Omnicrola/filking-hats/hat-conductor/hat-conductor.ino

#include "config.h"
#include "settings.h"
#include "display.h"
#include "audio.h"
#include "radio.h"
#include "web.h"
#include "mode.h"
#include "bell.h"
#include <WiFi.h>

void setup() {
#if DEBUG
  Serial.begin(115200);
#endif
  settingsBegin();
  displayBegin();
  startupChase();
  bool micOk = audioBegin();
  bool radioOk = radioBegin();
  webBegin();
  DBG("conductor v%u mic %s, radio %s ch %u, web http://%s\n", FIRMWARE_VERSION, micOk ? "ok" : "FAIL",
      radioOk ? "ok" : "FAIL", radioChannel(), WiFi.softAPIP().toString().c_str());
}

void metronomeLoop() {
  static uint32_t lastFrameMs = 0;
  uint32_t now = millis();
  if (now - lastFrameMs >= METRONOME_FRAME_MS) {
    lastFrameMs = now;
    uint8_t level, hue;
    metronomeFrame(level, hue);
    broadcast(level, hue, MODE_METRONOME);
    renderBar(level, hue);
  }
  webHandle();
}

void loop() {
  if (modeCurrent() == MODE_METRONOME) {
    metronomeLoop();
    return;
  }
  uint8_t mode = modeCurrent();
  AudioFrame f = audioProcess(mode == MODE_FREQUENCY);
  broadcast(f.level, f.hue, mode);
  if (mode == MODE_FREQUENCY) broadcastSpectrum(f.bands);
  if (mode == MODE_BELL) bellFrame(f);
  else if (mode == MODE_SLEEP) renderOff();
  else if (mode == MODE_FREQUENCY) renderSpectrum(f.bands);
  else renderBar(f.level, f.hue);
  webUpdate(f);
  webHandle();
  DBG("db %6.1f ref %6.1f lvl %3u f %6.0f hue %3u rx %d%s\n", f.db, f.refDb, f.level, f.freq, f.hue,
      radioReceiverCount(), f.gated ? " gated" : "");
}
