Omnicrola/filking-hats/hat-receiver/radio.cpp

#include "radio.h"
#include "config.h"
#include <WiFi.h>
#include <esp_now.h>
#include <esp_wifi.h>
#include <Preferences.h>

static const uint8_t BROADCAST_ADDR[6] = {0xFF, 0xFF, 0xFF, 0xFF, 0xFF, 0xFF};
static portMUX_TYPE rxMux = portMUX_INITIALIZER_UNLOCKED;
static volatile uint8_t rxLevel = 0;
static volatile uint8_t rxHue = 0;
static volatile uint8_t rxMode = MODE_REACTIVE;
static volatile int8_t rxRssi = -127;
static uint8_t rxBands[NUM_LEDS];
static int8_t rxBellIndex = -1;
static uint8_t rxBellCount = 0;
static uint8_t rxBellWinner = 0xFF;
static uint8_t ownMac[6];
static volatile uint32_t rxTimeMs = 0;
static volatile uint32_t rxCount = 0;
static volatile uint32_t rxLost = 0;
static volatile uint8_t rxLastSeq = 0;
static volatile bool rxAny = false;
static volatile uint8_t cmdChannel = 0;
static Preferences prefs;
static uint8_t channel = DEFAULT_CHANNEL;
static uint8_t savedChannel = DEFAULT_CHANNEL;
static uint32_t lastHopMs = 0;

static void onReceive(const esp_now_recv_info_t *info, const uint8_t *data, int len) {
  if (len == sizeof(ChannelPacket)) {
    ChannelPacket cmd;
    memcpy(&cmd, data, sizeof(cmd));
    if (cmd.magic == CHANNEL_MAGIC && cmd.group == GROUP_ID && cmd.channel >= CHANNEL_MIN && cmd.channel <= CHANNEL_MAX)
      cmdChannel = cmd.channel;
    return;
  }
  if (len == sizeof(BellPacket)) {
    BellPacket bp;
    memcpy(&bp, data, sizeof(bp));
    if (bp.magic != BELL_MAGIC || bp.group != GROUP_ID) return;
    int8_t index = -1;
    int listed = min((int)bp.count - 1, BELL_MAX_RECEIVERS);
    for (int i = 0; i < listed; i++) {
      if (memcmp(bp.macs[i], ownMac, 6) == 0) {
        index = i + 1;
        break;
      }
    }
    taskENTER_CRITICAL(&rxMux);
    rxBellIndex = index;
    rxBellCount = bp.count;
    rxBellWinner = bp.winner;
    taskEXIT_CRITICAL(&rxMux);
    return;
  }
  if (len == sizeof(SpectrumPacket)) {
    SpectrumPacket sp;
    memcpy(&sp, data, sizeof(sp));
    if (sp.magic != SPECTRUM_MAGIC || sp.group != GROUP_ID) return;
    taskENTER_CRITICAL(&rxMux);
    memcpy(rxBands, sp.bands, NUM_LEDS);
    taskEXIT_CRITICAL(&rxMux);
    return;
  }
  if (len != sizeof(HatPacket)) return;
  HatPacket pkt;
  memcpy(&pkt, data, sizeof(pkt));
  if (pkt.magic != PACKET_MAGIC || pkt.group != GROUP_ID) return;
  taskENTER_CRITICAL(&rxMux);
  if (rxAny) rxLost += (uint8_t)(pkt.seq - rxLastSeq - 1);
  rxLastSeq = pkt.seq;
  rxLevel = pkt.level;
  rxHue = pkt.hue;
  rxMode = pkt.mode;
  rxRssi = info->rx_ctrl ? (int8_t)info->rx_ctrl->rssi : -127;
  rxTimeMs = millis();
  rxCount++;
  rxAny = true;
  taskEXIT_CRITICAL(&rxMux);
}

static void setChannel(uint8_t ch) {
  channel = ch;
  esp_wifi_set_channel(channel, WIFI_SECOND_CHAN_NONE);
}

bool radioBegin() {
  prefs.begin("radio", false);
  savedChannel = prefs.getUChar("channel", DEFAULT_CHANNEL);
  if (savedChannel < CHANNEL_MIN || savedChannel > CHANNEL_MAX) savedChannel = DEFAULT_CHANNEL;
  WiFi.mode(WIFI_STA);
  WiFi.disconnect();
  esp_wifi_set_ps(WIFI_PS_NONE);
  setChannel(savedChannel);
  esp_wifi_get_mac(WIFI_IF_STA, ownMac);
  if (esp_now_init() != ESP_OK) return false;
  esp_now_peer_info_t peer = {};
  memcpy(peer.peer_addr, BROADCAST_ADDR, 6);
  peer.channel = 0;
  peer.ifidx = WIFI_IF_STA;
  peer.encrypt = false;
  if (esp_now_add_peer(&peer) != ESP_OK) return false;
  return esp_now_register_recv_cb(onReceive) == ESP_OK;
}

void radioSendHeartbeat() {
  HeartbeatPacket pkt = {HEARTBEAT_MAGIC, GROUP_ID, FIRMWARE_VERSION};
  esp_now_send(BROADCAST_ADDR, (const uint8_t *)&pkt, sizeof(pkt));
}

String radioHatId() {
  uint8_t mac[6];
  esp_wifi_get_mac(WIFI_IF_STA, mac);
  char buf[9];
  snprintf(buf, sizeof(buf), "%02X:%02X:%02X", mac[3], mac[4], mac[5]);
  return String(buf);
}

RadioState radioSnapshot() {
  RadioState s;
  taskENTER_CRITICAL(&rxMux);
  s.any = rxAny;
  s.level = rxLevel;
  s.hue = rxHue;
  s.mode = rxMode;
  s.rssi = rxRssi;
  memcpy(s.bands, rxBands, NUM_LEDS);
  s.bellIndex = rxBellIndex;
  s.bellCount = rxBellCount;
  s.bellWinner = rxBellWinner;
  s.lastRxMs = rxTimeMs;
  s.count = rxCount;
  s.lost = rxLost;
  taskEXIT_CRITICAL(&rxMux);
  return s;
}

void radioUpdate(bool lost) {
  uint8_t cmd = cmdChannel;
  cmdChannel = 0;
  uint32_t now = millis();
  if (cmd && cmd != channel) {
    setChannel(cmd);
    lastHopMs = now;
    DBG("channel -> %u (conductor)\n", channel);
  } else if (lost && now - lastHopMs >= SCAN_DWELL_MS) {
    lastHopMs = now;
    setChannel(channel >= CHANNEL_MAX ? CHANNEL_MIN : channel + 1);
  }
  if (!lost && channel != savedChannel && now - lastHopMs >= SCAN_DWELL_MS) {
    savedChannel = channel;
    prefs.putUChar("channel", savedChannel);
    DBG("channel %u saved\n", savedChannel);
  }
}

uint8_t radioChannel() {
  return channel;
}
