Omnicrola/filking-hats/hat-conductor/settings.h

#pragma once

#include <Arduino.h>

struct Settings {
  float gateDbfs;
  float minFreqHz;
  float releasePerS;
  float agcDecayDbPerS;
};

void settingsBegin();
const Settings &settings();
void settingsSave(const Settings &s);
void settingsReset();
uint8_t settingsChannel();
void settingsSaveChannel(uint8_t channel);
