Omnicrola/filking-hats/(commit log)

2026-11-09 Add broadcast channel switching from the Hats page
    The conductor announces the new channel for 1.5 s, then moves its
    access point and ESP-NOW and saves the choice. Receivers follow the
    conductor's channel beacon, scan channels 1-11 when the signal is
    lost, and save the channel they lock onto. Firmware version 2.
2026-11-09 Tap the Hz readout to show the nearest note
    The Tuning view's Hz card toggles between frequency and the nearest
    12-tone equal-temperament note (A4 = 440 Hz). The choice is remembered
    by the browser. Firmware version 3.
2026-11-09 Add Modes page with Reactive mode
    The data packet gains a mode byte (now 7 bytes). The conductor keeps
    the current mode in RAM only, so it boots into Reactive, and receivers
    fall back to Reactive until they hear the conductor. The new Modes view
    switches the mode through /api/mode. Firmware version 4.
2026-11-09 Add Sleep mode
    All LEDs off on every hat; receivers ignore level and color and stay
    dark rather than red if the conductor goes quiet while sleeping.
2026-11-09 Add Ranged mode
    Receivers light only the first LED, colored from red to green by the
    smoothed signal strength of the conductor's packets.
2026-11-09 Add Metronome mode with BPM slider
    The conductor ignores the microphone and broadcasts a beat every
    60/BPM seconds, 100 frames per second, with the first beat of each bar
    of 4 in white. The Modes view gets a 40-300 BPM tempo slider (RAM only,
    default 120). Receivers render metronome frames without smoothing.
2026-11-09 Add Frequency mode
    Every LED stays lit, each showing the volume of one log-spaced slice of
    80-500 Hz. The conductor runs a 2048-point FFT over the last 128 ms of
    unfiltered audio and applies the Reactive AGC, noise floor, attack and
    bar decay per slice, then sends an 18-byte spectrum packet after each
    data packet. Firmware version 5.
    [audio.cpp, audio.h, config.h, display.cpp, display.h, hat-conductor.ino, hat-receiver.ino, radio.cpp]
2026-11-11 Add Bell Choir mode
    Each active hat (the conductor plus receivers heard in the last 5 s)
    owns one log-spaced slice of 80-500 Hz: the conductor takes the lowest,
    receivers follow in MAC order, and slices are redistributed as hats
    come and go. Each frame the loudest slice's hat goes to full brightness
    in its positional palette color while the rest fade to a dim glow over
    1 s. A fixed-size 197-byte bell packet carries the order and winner.
    Firmware version 6.
    [audio.cpp, audio.h, bell.cpp, config.h, display.cpp, display.h, hat-conductor.ino]
2026-11-11 Align Bell Choir bands to semitones
    Each hat owns a run of whole notes from D#2 to B4, measured per note
    with a windowed Goertzel filter.
